vim449/me3230-robot/state_transition2.png

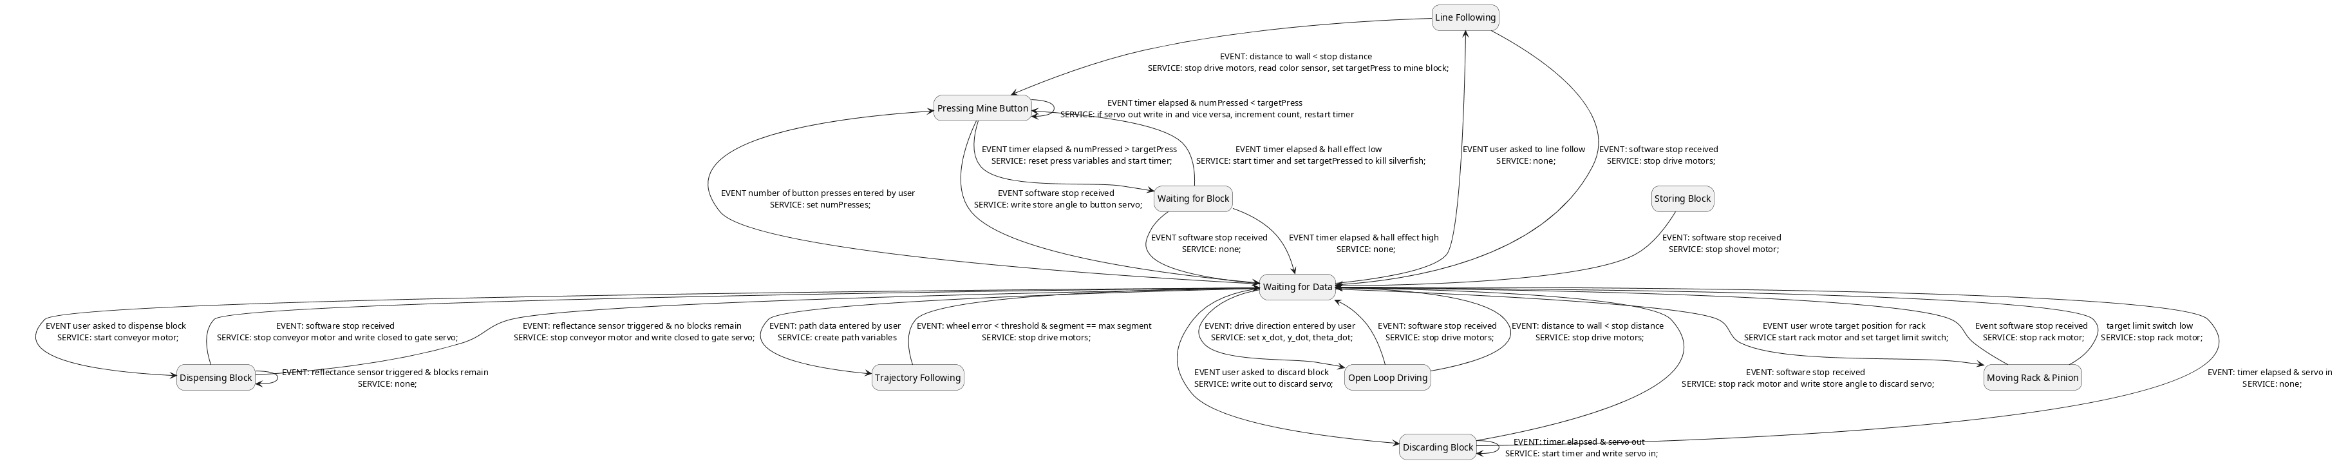
state_transition2.png
