vim449/me3230-robot/schematic/motor.kicad_sch

## KiCad design schematic/motor.kicad_sch (2026-03-25, an earlier design)

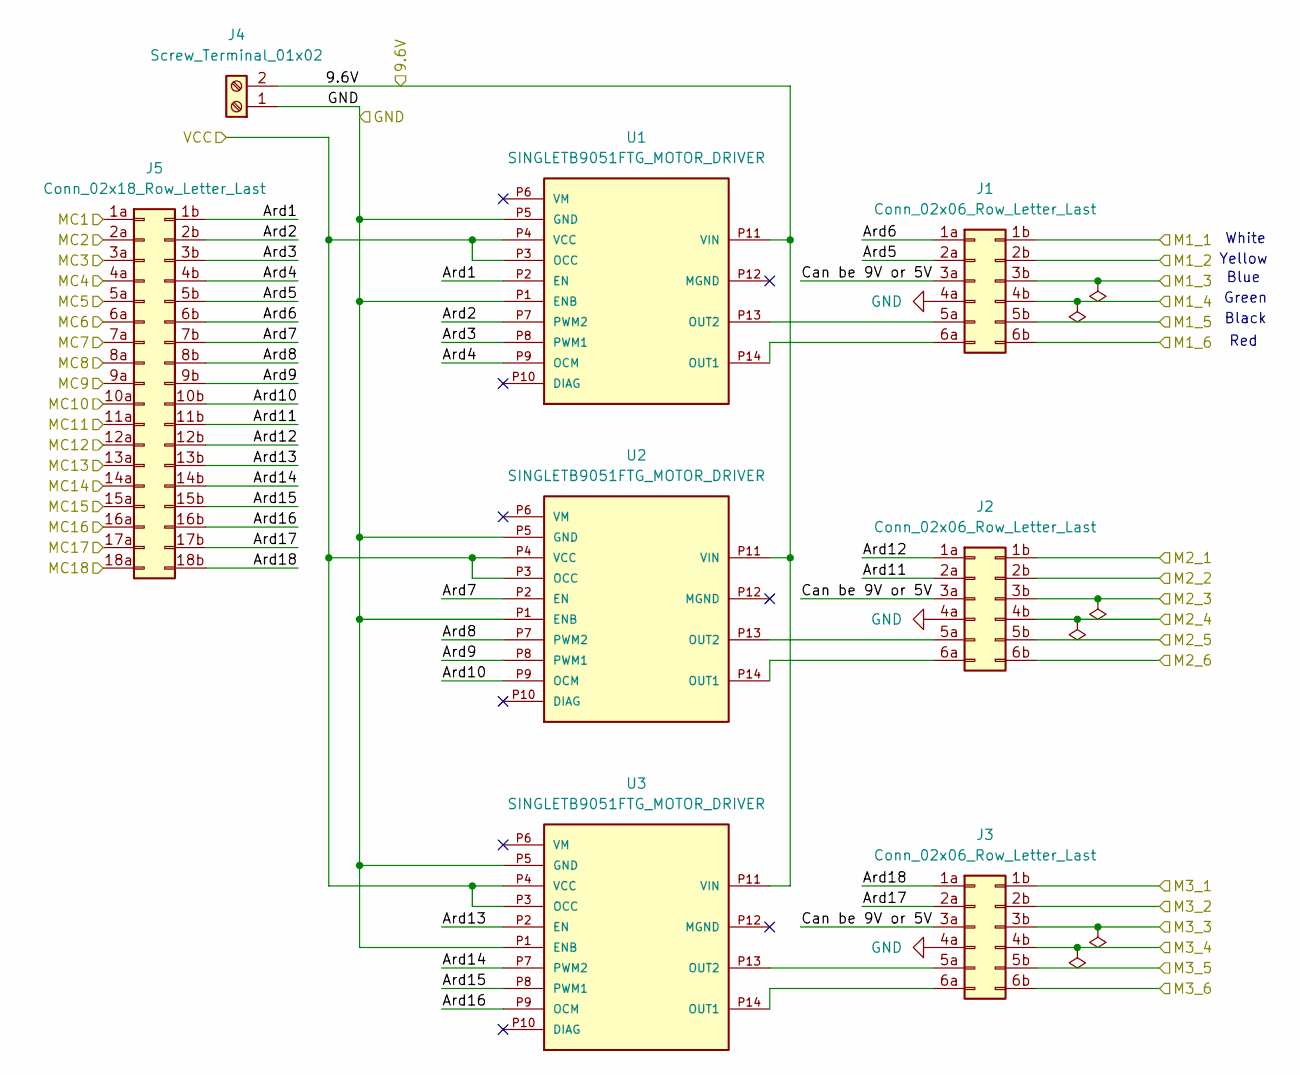
[picture p4: schematic motor.kicad_sch]

Parts:
J1, J2, J3: Conn_02x06_Row_Letter_Last
J4: Screw_Terminal_01x02
J5: Conn_02x18_Row_Letter_Last
U1, U2, U3: SINGLETB9051FTG_MOTOR_DRIVER; SINGLETB9051FTG

Connections:
9.6V: J4.2, U1.P11 (VIN), U2.P11 (VIN), U3.P11 (VIN)
Ard1: J5.1b, U1.P2 (EN)
Ard2: J5.2b, U1.P7 (PWM2)
Ard3: J5.3b, U1.P8 (PWM1)
Ard4: J5.4b, U1.P9 (OCM)
Ard5: J1.2a, J5.5b
Ard6: J1.1a, J5.6b
Ard7: J5.7b, U2.P2 (EN)
Ard8: J5.8b, U2.P7 (PWM2)
Ard9: J5.9b, U2.P8 (PWM1)
Ard10: J5.10b, U2.P9 (OCM)
Ard11: J2.2a, J5.11b
Ard12: J2.1a, J5.12b
Ard13: J5.13b, U3.P2 (EN)
Ard14: J5.14b, U3.P7 (PWM2)
Ard15: J5.15b, U3.P8 (PWM1)
Ard16: J5.16b, U3.P9 (OCM)
Ard17: J3.2a, J5.17b
Ard18: J3.1a, J5.18b
Can be 9V or 5V: J1.3a, J2.3a, J3.3a
GND: J1.4a, J2.4a, J3.4a, J4.1, U1.P1 (ENB), U1.P5 (GND), U2.P1 (ENB), U2.P5 (GND), U3.P1 (ENB), U3.P5 (GND)
M1_1: J1.1b
M1_2: J1.2b
M1_3: J1.3b
M1_4: J1.4b
M1_5: J1.5b
M1_6: J1.6b
M2_1: J2.1b
M2_2: J2.2b
M2_3: J2.3b
M2_4: J2.4b
M2_5: J2.5b
M2_6: J2.6b
M3_1: J3.1b
M3_2: J3.2b
M3_3: J3.3b
M3_4: J3.4b
M3_5: J3.5b
M3_6: J3.6b
MC1: J5.1a
MC2: J5.2a
MC3: J5.3a
MC4: J5.4a
MC5: J5.5a
MC6: J5.6a
MC7: J5.7a
MC8: J5.8a
MC9: J5.9a
MC10: J5.10a
MC11: J5.11a
MC12: J5.12a
MC13: J5.13a
MC14: J5.14a
MC15: J5.15a
MC16: J5.16a
MC17: J5.17a
MC18: J5.18a
unnamed: J1.5a, U1.P13 (OUT2)
unnamed: J1.6a, U1.P14 (OUT1)
unnamed: J2.5a, U2.P13 (OUT2)
unnamed: J2.6a, U2.P14 (OUT1)
unnamed: J3.5a, U3.P13 (OUT2)
unnamed: J3.6a, U3.P14 (OUT1)
VCC: U1.P3 (OCC), U1.P4 (VCC), U2.P3 (OCC), U2.P4 (VCC), U3.P3 (OCC), U3.P4 (VCC)

Notes on the sheet:
Blue
Red
Green
Yellow
White
Black
