vim449/me3230-robot/schematic/robot.kicad_sch

## KiCad design schematic/robot.kicad_sch (2026-04-04, an earlier design)

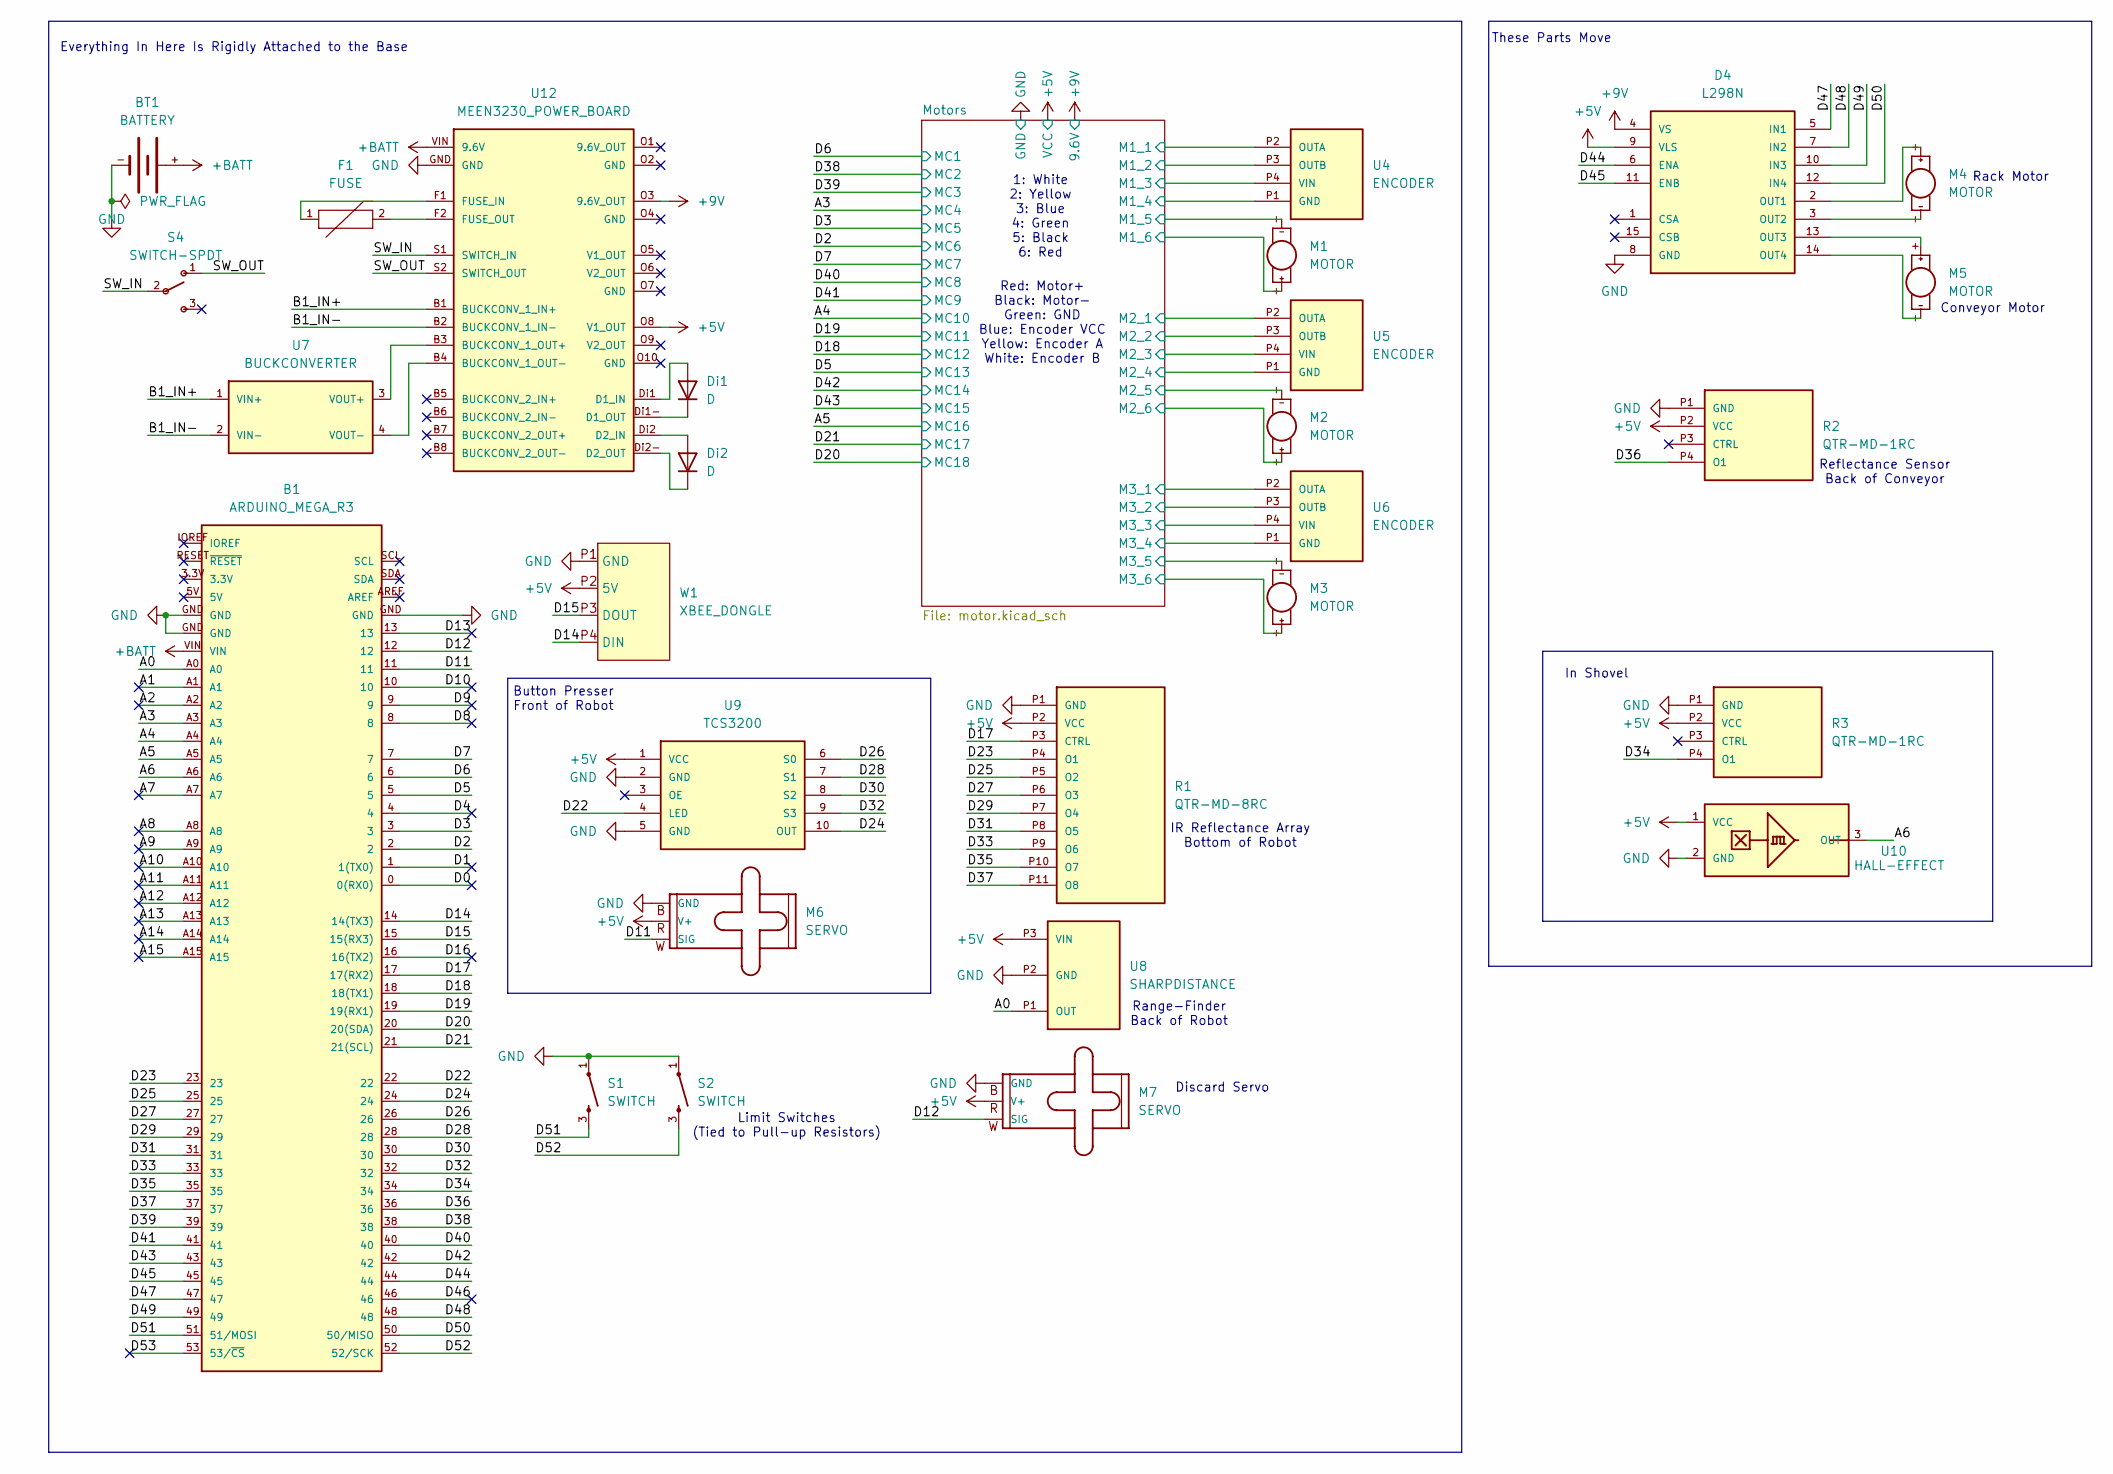
[picture p5: schematic robot.kicad_sch]

Parts:
B1: ARDUINO_MEGA_R3; ARDUINO_MEGA_NO_SILK
BT1: BATTERY; Power Terminal
D4: L298N; L298
Di1, Di2: D
F1: FUSE; Fuse Holder
M1, M2, M3, M4, M5: MOTOR; VIBE-MOTOR-10MM
M6, M7: SERVO; SERVOFOOTPRINT
R1: QTR-MD-8RC; QTRMD8
R2, R3: QTR-MD-1RC; QTRMD1
S1, S2: SWITCH; Header3
S4: SWITCH-SPDT; SWITCH_SPDT_SMD
U4, U5, U6: ENCODER
U7: BUCKCONVERTER; BuckConverter
U8: SHARPDISTANCE
U9: TCS3200
U10: HALL-EFFECT; HALLEFFECT
U12: MEEN3230_POWER_BOARD
W1: XBEE_DONGLE

Connections:
+5V: D4.9 (VLS), M6., M7., R1.P2 (VCC), R2.P2 (VCC), R3.P2 (VCC), U8.P3 (VIN), U9.1 (VCC), U10.1 (VCC), U12.O8 (V1_OUT), W1.P2 (5V)
+9V: D4.4 (VS), U12.O3 (9.6V_OUT)
+BATT: B1.VIN, BT1.+, U12.VIN (9.6V)
A0: B1.A0, U8.P1 (OUT)
A1: B1.A1
A2: B1.A2
A3: B1.A3
A4: B1.A4
A5: B1.A5
A6: B1.A6, U10.3 (OUT)
A7: B1.A7
A8: B1.A8
A9: B1.A9
A10: B1.A10
A11: B1.A11
A12: B1.A12
A13: B1.A13
A14: B1.A14
A15: B1.A15
B1_IN+: U7.1 (VIN+), U12.B1 (BUCKCONV_1_IN+)
B1_IN-: U7.2 (VIN-), U12.B2 (BUCKCONV_1_IN-)
D0: B1.0 (0(RX0))
D1: B1.1 (1(TX0))
D2: B1.2
D3: B1.3
D4: B1.4
D5: B1.5
D6: B1.6
D7: B1.7
D8: B1.8
D9: B1.9
D10: B1.10
D11: B1.11, M6.
D12: B1.12, M7.
D13: B1.13
D14: B1.14 (14(TX3)), W1.P4 (DIN)
D15: B1.15 (15(RX3)), W1.P3 (DOUT)
D16: B1.16 (16(TX2))
D17: B1.17 (17(RX2)), R1.P3 (CTRL)
D18: B1.18 (18(TX1))
D19: B1.19 (19(RX1))
D20: B1.20 (20(SDA))
D21: B1.21 (21(SCL))
D22: B1.22, U9.4 (LED)
D23: B1.23, R1.P4 (O1)
D24: B1.24, U9.10 (OUT)
D25: B1.25, R1.P5 (O2)
D26: B1.26, U9.6 (S0)
D27: B1.27, R1.P6 (O3)
D28: B1.28, U9.7 (S1)
D29: B1.29, R1.P7 (O4)
D30: B1.30, U9.8 (S2)
D31: B1.31, R1.P8 (O5)
D32: B1.32, U9.9 (S3)
D33: B1.33, R1.P9 (O6)
D34: B1.34, R3.P4 (O1)
D35: B1.35, R1.P10 (O7)
D36: B1.36, R2.P4 (O1)
D37: B1.37, R1.P11 (O8)
D38: B1.38
D39: B1.39
D40: B1.40
D41: B1.41
D42: B1.42
D43: B1.43
D44: B1.44, D4.6 (ENA)
D45: B1.45, D4.11 (ENB)
D46: B1.46
D47: B1.47, D4.5 (IN1)
D48: B1.48, D4.7 (IN2)
D49: B1.49, D4.10 (IN3)
D50: B1.50 (50/MISO), D4.12 (IN4)
D51: B1.51 (51/MOSI), S1.3
D52: B1.52 (52/SCK), S2.3
D53: B1.53 (53/~CS)
GND: B1.GND, BT1.-, D4.8 (GND), M6., M7., R1.P1 (GND), R2.P1 (GND), R3.P1 (GND), S1.1, S2.1, U8.P2 (GND), U9.2 (GND), U9.5 (GND), U10.2 (GND), U12.GND, W1.P1 (GND)
M1_1: U4.P2 (OUTA)
M1_2: U4.P3 (OUTB)
M1_3: U4.P4 (VIN)
M1_4: U4.P1 (GND)
M1_5: M1.-
M1_6: M1.+
M2_1: U5.P2 (OUTA)
M2_2: U5.P3 (OUTB)
M2_3: U5.P4 (VIN)
M2_4: U5.P1 (GND)
M2_5: M2.-
M2_6: M2.+
M3_1: U6.P2 (OUTA)
M3_2: U6.P3 (OUTB)
M3_3: U6.P4 (VIN)
M3_4: U6.P1 (GND)
M3_5: M3.-
M3_6: M3.+
unnamed: D4.2 (OUT1), M4.+
unnamed: D4.3 (OUT2), M4.-
unnamed: D4.13 (OUT3), M5.+
unnamed: D4.14 (OUT4), M5.-
unnamed: Di1.1 (K), U12.Di1- (D1_OUT)
unnamed: Di1.2 (A), U12.Di1 (D1_IN)
unnamed: Di2.1 (K), U12.Di2- (D2_OUT)
unnamed: Di2.2 (A), U12.Di2 (D2_IN)
unnamed: F1.1, U12.F1 (FUSE_IN)
unnamed: F1.2, U12.F2 (FUSE_OUT)
unnamed: U7.3 (VOUT+), U12.B3 (BUCKCONV_1_OUT+)
unnamed: U7.4 (VOUT-), U12.B4 (BUCKCONV_1_OUT-)
SW_IN: S4.2, U12.S1 (SWITCH_IN)
SW_OUT: S4.1, U12.S2 (SWITCH_OUT)

Notes on the sheet:
Button Presser Front of Robot
Everything In Here Is Rigidly Attached to the Base
Conveyor Motor
In Shovel
These Parts Move
IR Reflectance Array Bottom of Robot
1: White 2: Yellow 3: Blue 4: Green 5: Black 6: Red
Reflectance Sensor Back of Conveyor
Limit Switches (Tied to Pull-up Resistors)
Discard Servo
Range-Finder Back of Robot
Red: Motor+ Black: Motor- Green: GND Blue: Encoder VCC Yellow: Encoder A White: Encoder B
Rack Motor
