vim449/me3230-robot/(commit log)

2026-02-12 Switch to PlatformIO
2026-02-12 greatly cleaned up electrical schematic
    [motor.kicad_sch, robot.kicad_sch]
2026-02-13 Writing to the right arduino mega
2026-02-13 Set up motor controls
2026-02-16 Forgot to update kicad schematic to match pin changes
    [robot.kicad_sch]
2026-02-16 Added discard servo to schematic
    [robot.kicad_sch]
2026-02-16 Switched to pull-up limit-switches
    [robot.kicad_sch]
2026-02-16 slightly less fucked motor init
2026-02-17 removed tertiary limit switch
    [robot.kicad_sch]
2026-02-17 added schematic render to repo
2026-02-18 wireless comms test
2026-02-19 Schematic Overhaul
    [motor.kicad_sch, robot.kicad_sch]
2026-02-20 Fixed ENB jumper
    [motor.kicad_sch]
2026-02-20 Schematic update for previous commit
2026-02-23 Schematic disagreed with code
    [robot.kicad_sch]
2026-02-23 forgot to update schematic pdf, should really make this a git hook
2026-02-24 beginning of wireless refactoring
2026-02-24 made schematics folder for my own sanity
    [motor.kicad_sch, robot.kicad_pcb, robot.kicad_sch]
2026-02-24 Fixed the build errors lmao
    [extern.h, followLine.cpp, main.cpp, parseData.cpp, sending.h]
2026-02-25 Full PM7 working
    [motor.kicad_sch, robot.kicad_sch]
2026-03-02 I don't even know at this point, so much changed
    [motor.kicad_sch, robot.kicad_sch]
2026-03-02 Added second rangefinder to schematic
    [robot.kicad_sch]
2026-03-02 initializing the filter with bias values would help
2026-03-02 Don't double count first filter iter
2026-03-03 moved servo pins because PWMServo is jank AF
    [robot.kicad_sch]
2026-03-05 Added support to print silverfish
2026-03-13 made code agnostic to number of drive motors
2026-03-17 Full code for PM9, wireless receiving is untested though
2026-03-25 updated schematic
    [motor.kicad_sch, robot.kicad_sch]
2026-03-26 updated .gitignore for new kicad ver
2026-04-04 added shovel switch
    [robot.kicad_sch]
